Juanfesol21/rural_transport_alternative/hardware/Station_circuit.png

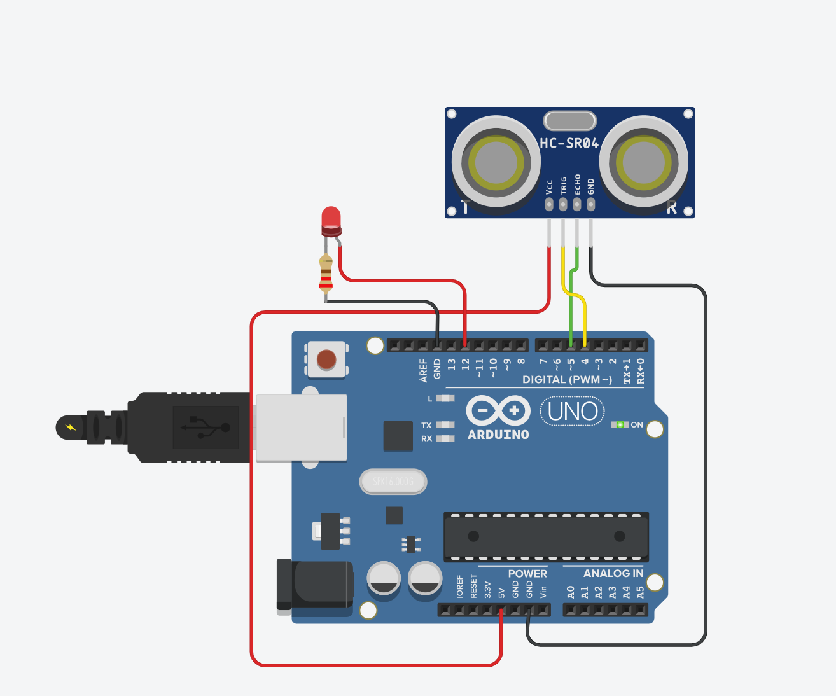
hardware/Station_circuit.png
