Juanfesol21/rural_transport_alternative/hardware/Vehicle_circuit.png

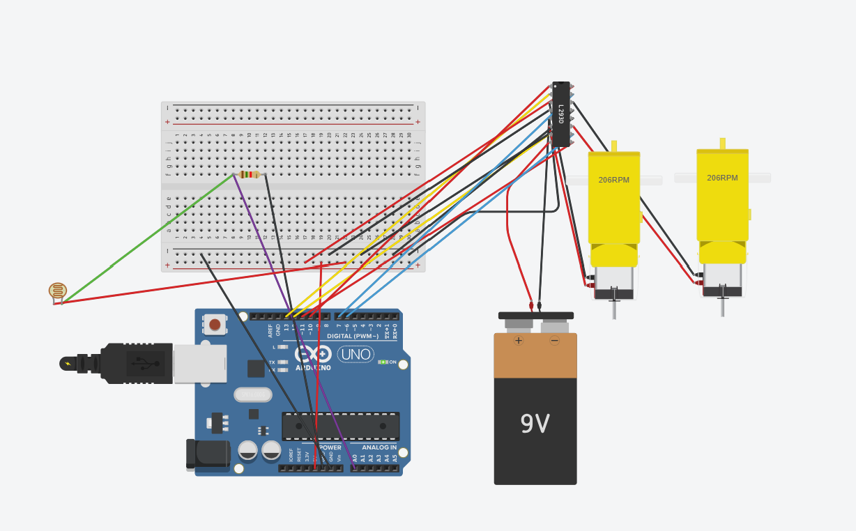
hardware/Vehicle_circuit.png
