Juanfesol21/rural_transport_alternative/media/WhatsApp Image 2026-09-19 at 9.15.56 PM (1).jpeg

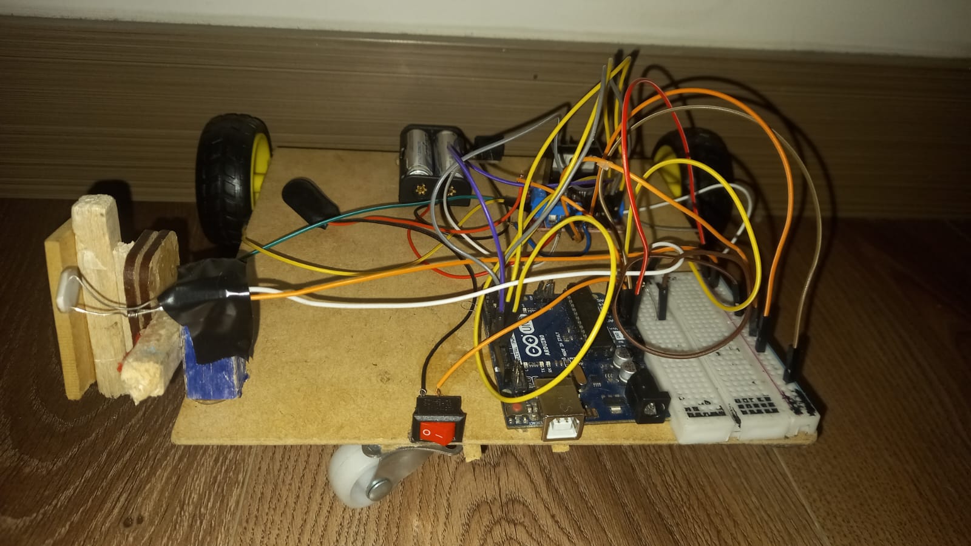
media/WhatsApp Image 2026-09-19 at 9.15.56 PM (1).jpeg
