Juanfesol21/rural_transport_alternative/hardware/Station_schematic.pdf

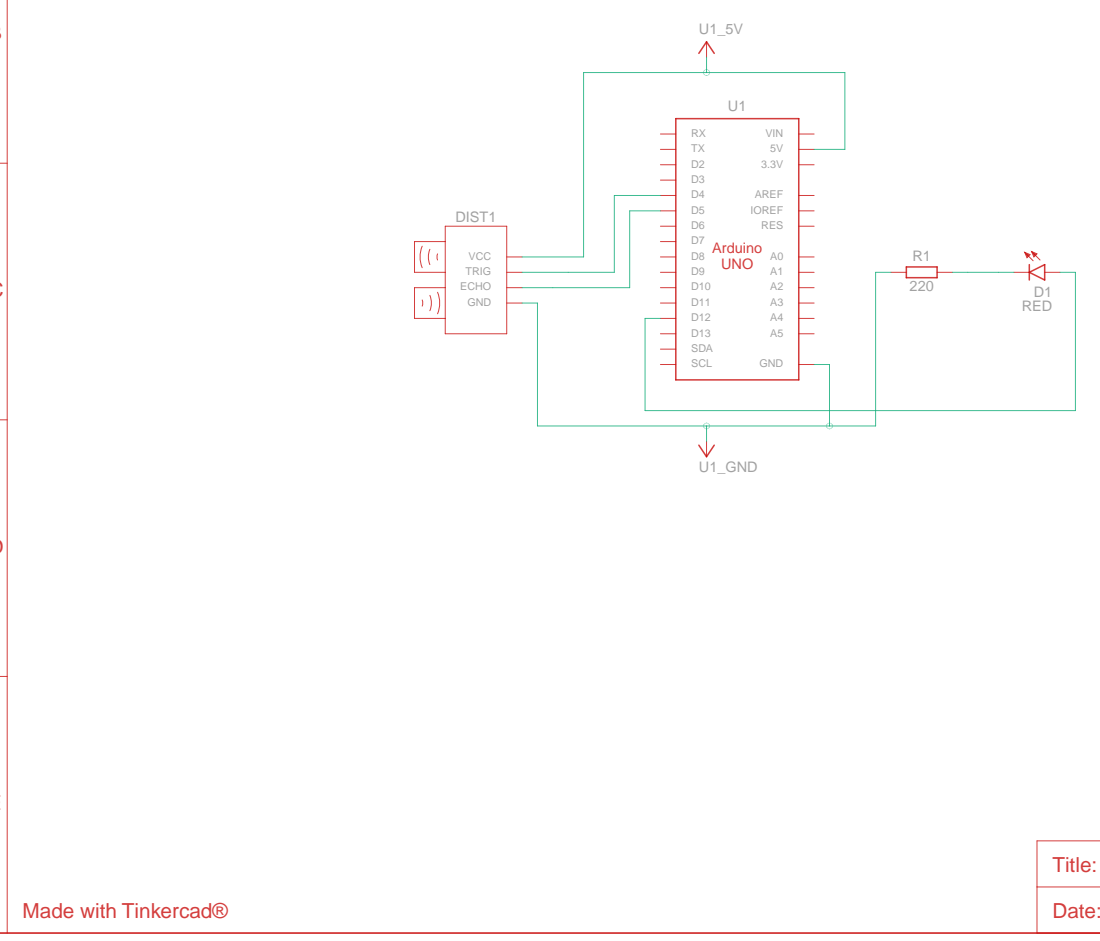
[picture p8: page 1]

Title: Frantic Elzing-Kup
