Juanfesol21/rural_transport_alternative/hardware/Vehicle_schematic.pdf

A

1 | 2 | 3 | 4 | 5 | 6

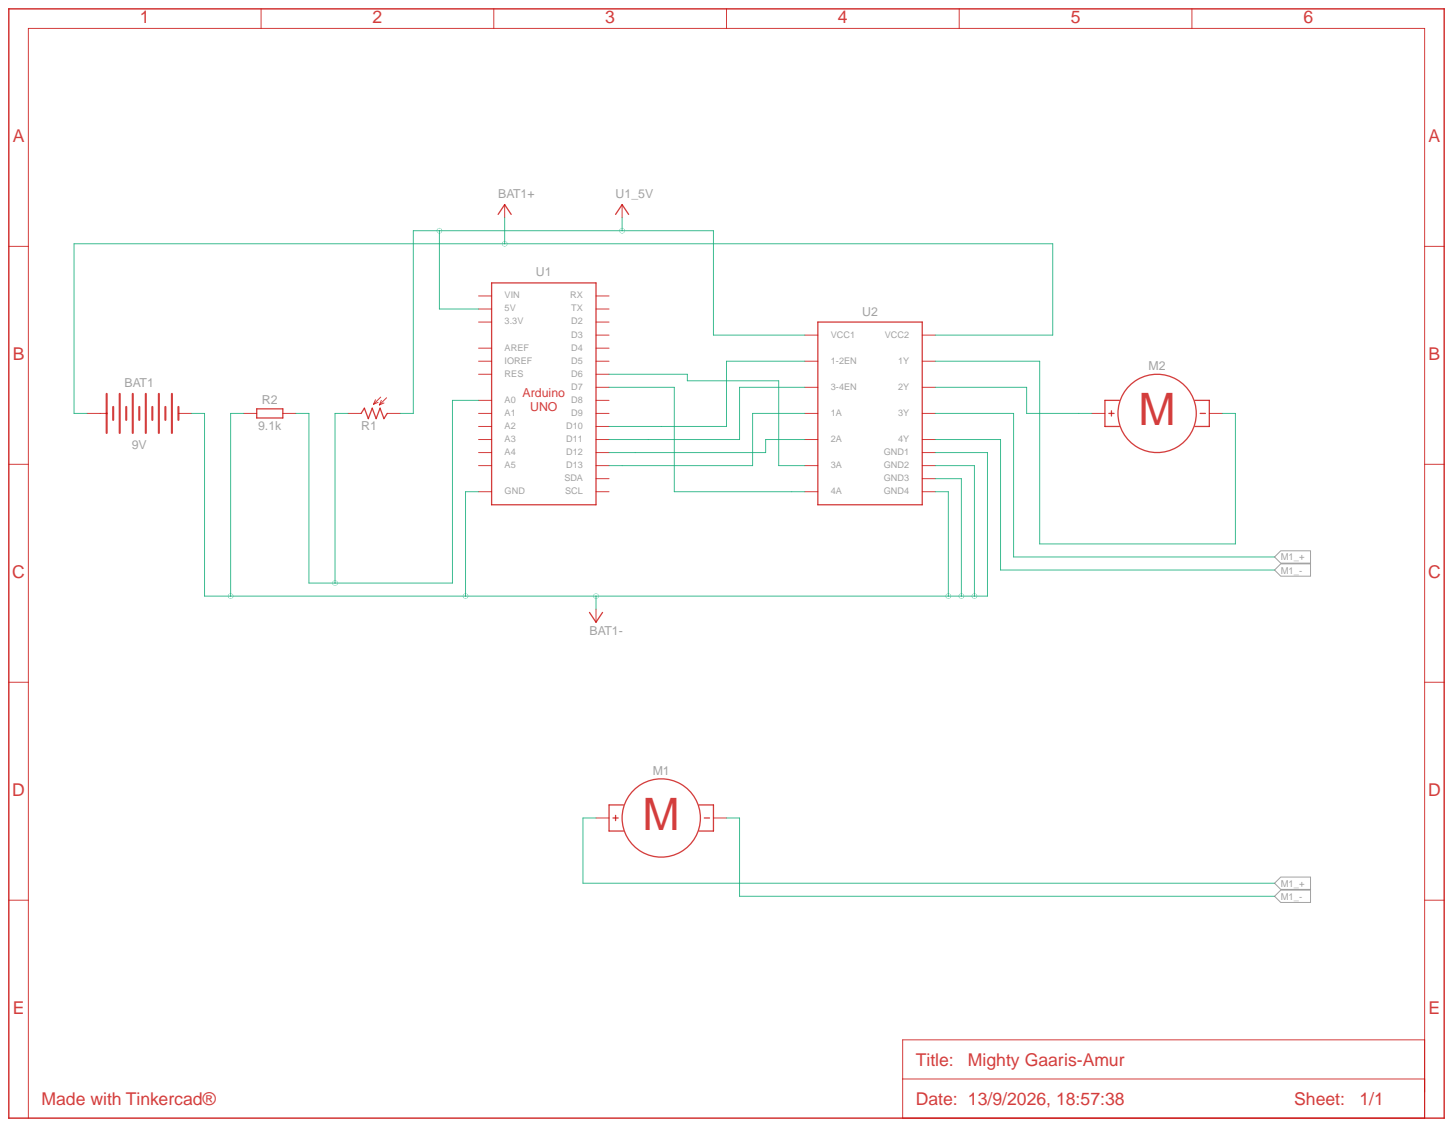
[picture p9: page 1]

Title: Mighty Gaaris-Amur
